JavierGranadoCIRCE/Alimak_RFID/mouser.png

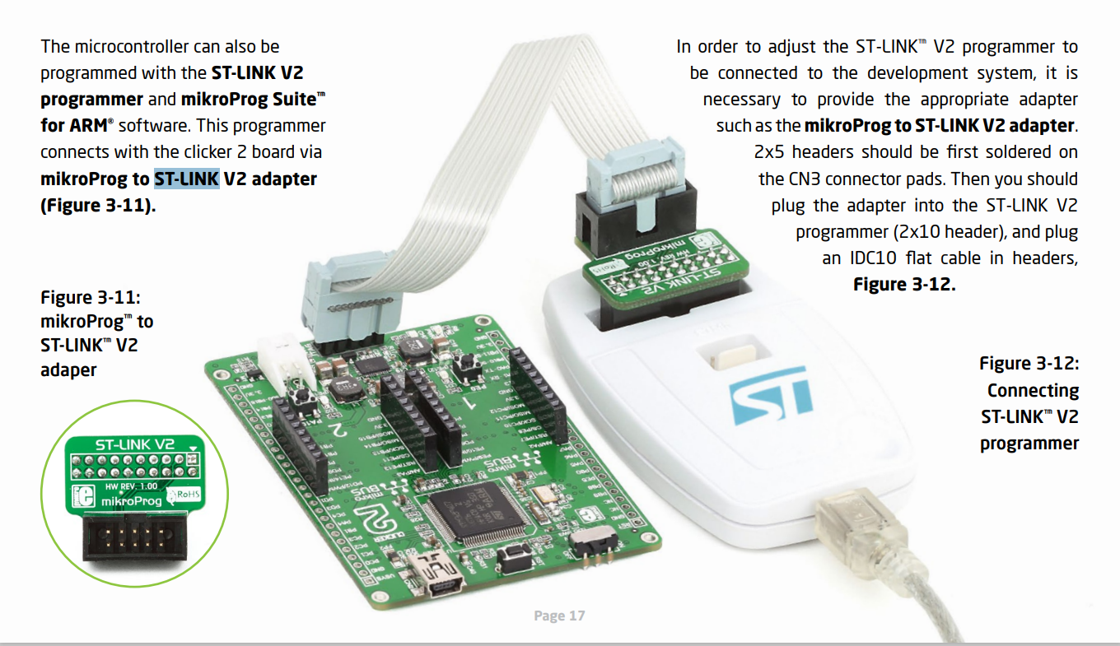
mouser.png
