JavierGranadoCIRCE/Alimak_RFID/Seguimiento_Doorlock_ALIMAK_19122025.odp

Actualización 19/12/2025

- Hemos puesto en marcha el setup del RFID
- Hemos verificado que a una distancia de unos 3 cm se detectan los Tags
- Hemos conseguido que funcione también quitando la antena de la pcb y sustituyéndola por una antena smd y modificando los condensadores del circuito resonante de la antena
- Vamoa a ir implementando el firmware para comunicarnos con el lector RFID desde el uControlador ST32

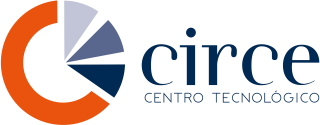
[picture p30: figure]
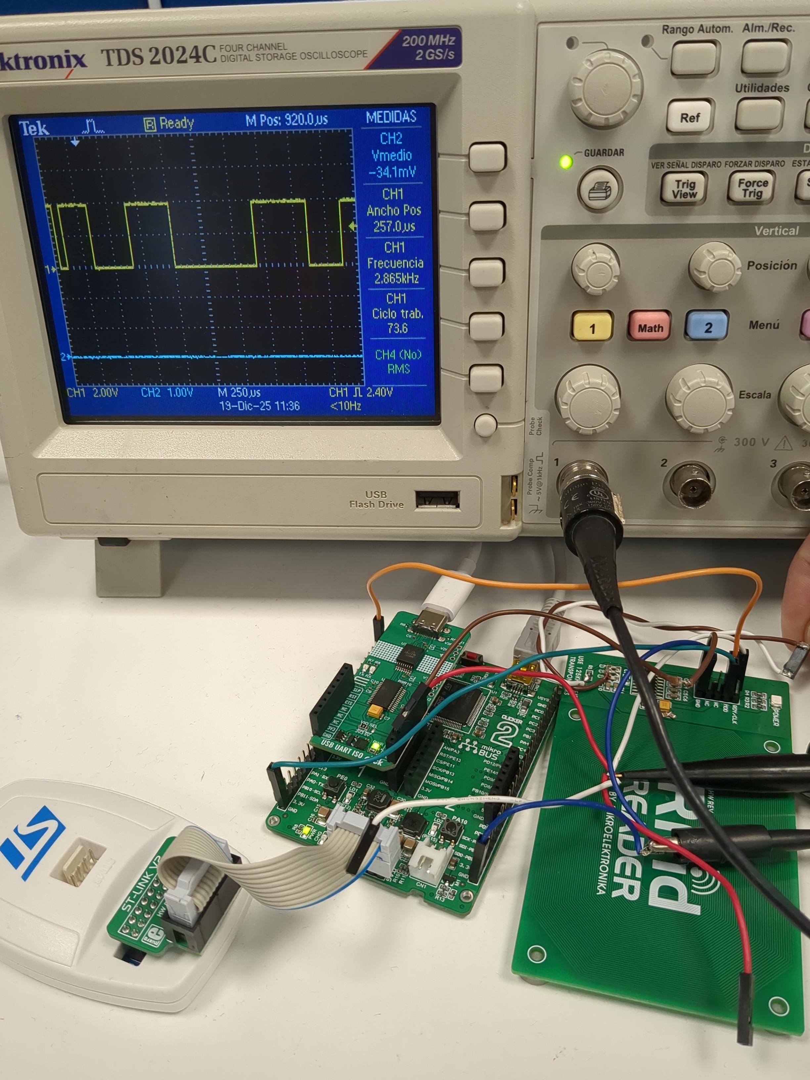
[picture p31: figure]
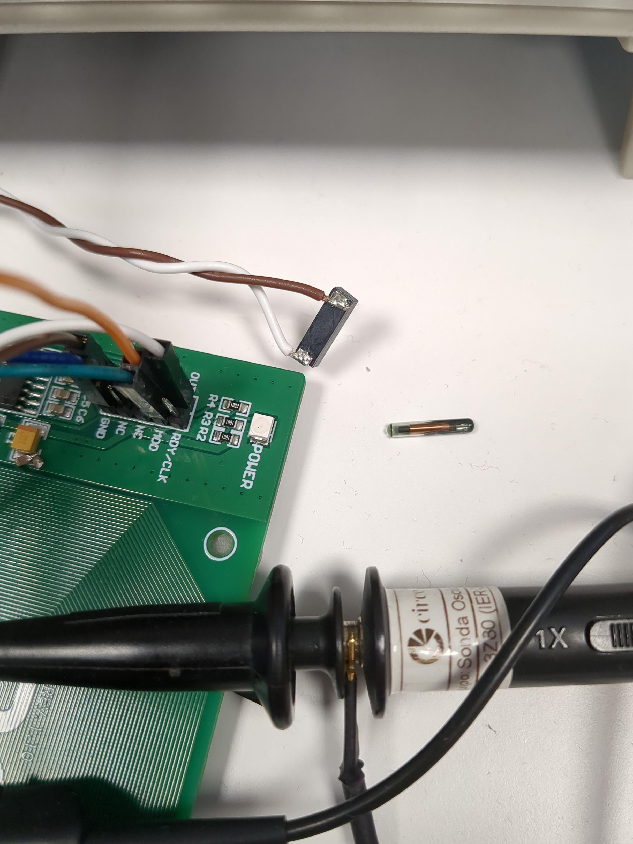
[picture p32: figure]

Notes: 101
