JavierGranadoCIRCE/Alimak_RFID/Seguimiento_Doorlock_ALIMAK_31102025.odp

## Slide 3

Estudio sensores Hall (puerta bloqueada)

Notes: 84

## Slide 4

Estudio sensores Hall (puerta bloqueada)

Problema del diseño actual:

Con dos sensores Hall digitales (todo/nada) que leen un mismo imán, hay redundancia, pero:

  - No hay forma de detectar fallos correlados (CCF) como que ambos se saturen o cortocircuiten a “1” o a “0”.
  - El DCavg (cobertura diagnóstica) es prácticamente nulo si solo se lee sus estados lógicos.
  - Si ambos sensores quedan atascados en nivel alto, el sistema podría pensar que el bloqueo está hecho cuando no lo está → fallo peligroso no detectado.

Eso impide justificar PLd…

Notes: CCF: Common Cause Failure, o fallo por causa común. Se refiere a la probabilidad de que ambos canales redundantes fallen a la vez por la misma causa (por ejemplo, una sobretensión, una temperatura extrema, un error de diseño, interferencias electromagnéticas, etc.). En una arquitectura redundante de seguridad (como dos relés K1 y K2): - Se asume que cada canal puede fallar independientemente. - Pero si una causa externa provoca que ambos fallen al mismo tiempo, la redundancia ya no protege nada.
- Por eso hay que demostrar que la probabilidad de fallo común está suficientemente reducida.
CCF ≥ 65: En la ISO 13849-1, el Anexo F establece un sistema de puntuación: - Cada medida de protección contra fallos comunes suma puntos. - Se exige alcanzar al menos 65 puntos para cumplir los requisitos de CCF en categorías 2, 3 y 4. Por eso se dice: “CCF ≥ 65” → los canales están suficientemente protegidos frente a fallos por causa común.
Cómo se consiguen esos puntos (según el Anexo F de la ISO 13849-1) -Separación física de canales 15 K1 y K2 en zonas distintas de la PCB y/o con pistas separadas. -Diversidad tecnológica o de diseño 20 Usar relés de distinto fabricante o controladores distintos. -Protección frente a sobretensiones, ruido EMI 10 TVS, filtros EMC, ferritas, optoaislamiento. -Fuentes de alimentación independientes 10 Cada canal con fusible o regulador separado. -Pruebas periódicas automáticas 15 Test de soldadura y discrepancia en cada ciclo. -Protección frente a sobretemperatura o vibración 5 Componentes certificados o pruebas de entorno. Si la suma de las medidas implementadas ≥ 65 → se considera que la probabilidad de fallo común es suficientemente baja.
CCF ≥ 65: separación física de canales, protección frente a sobretensiones, fuentes separadas o protecciones dedicadas, etc. (lista del Anexo F) Significa que: -Para alcanzar PL d, Cat. 3, nuestro diseño debe demostrar que los dos canales (K1 y K2) no pueden fallar simultáneamente por la misma causa. - Esto se logra aplicando las medidas anteriores (separación física, alimentación independiente, protección EMC, etc.) hasta acumular al menos 65 puntos en la tabla del Anexo F de la norma.
85

## Slide 5

Estudio sensores Hall (puerta bloqueada)

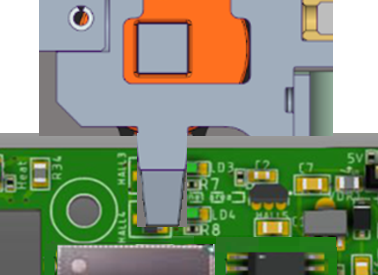
[picture p46: figure]

Sensores Hall digitales

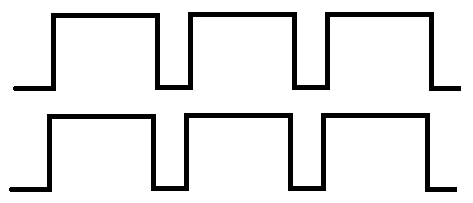
[picture p47: figure]

Hall1

Hall2

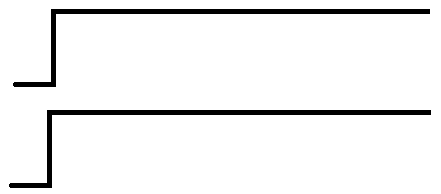
[picture p48: figure]

Cortocircuito a VCC en los dos sensores!!!

Fallo no detectado!!

Notes: 86

## Slide 6

Estudio sensores Hall (puerta bloqueada)

  - Propuesta: 2 sensores Hall analógicos redundantes
  - Características:
  - Diagnóstico de coherencia y plausibilidad
  - Hay que comparar Hall1 y Hall2 continuamente.
  - Si las dos lecturas difieren más allá de una ventana (ej. ±10 %), o si una se sale de rango (0 V, saturación, ruido), se genera fallo seguro.
  - Esto permite justificar DCavg medio/alto (~90 %) según el Anexo E de la norma (ISO 13849-1:2024)
  - Detección de fallos típicos:
  - Corto a GND o VCC → fuera de ventana.
  - Desmagnetización parcial → valor fuera de umbral.
  - Deriva térmica → incoherencia temporal.
  - Ruido o vibración → inestabilidad detectada por supervisión temporal.
  - Mitigación del fallo común (CCF):
  - Si se ubican físicamente separados (unos mm de diferencia en la trayectoria del imán).
  - Si se cablean en rutas independientes.
  - Si se alimentan por ramas separadas del MCU (ADC1/ADC2 con fuentes distintas).
  - Se puede justificar ≥ 65 pt en el Anexo F (CCF), lo que es requisito para PL d (ISO 13849-1:2024)
  - Ventana de validación física:
  - Al usar sensores analógicos, se puede definir una ventana de campo magnético válida (p. ej. entre 1.2 V y 2.8 V = pin bloqueado).
  - Si el imán está muy lejos o demasiado cerca, se considera no bloqueado o fallo.

Notes: MTTFd alto (30–100 años): “Mean Time To Dangerous Failure”, es decir, Tiempo medio hasta un fallo peligroso. Los sensores Hall no tienen partes móviles, por lo que su tasa de fallo aleatorio (λd) es muy baja. Según las tablas de la ISO 13849-1:2024, Anexo C, los dispositivos electrónicos simples con semiconductores estables pueden asignarse a la categoría MTTFd “High” (>30 años). Esto significa que la probabilidad de un fallo peligroso aleatorio es muy baja, y contribuye positivamente al cálculo global del Performance Level (PL). En la práctica, los valores típicos proporcionados por fabricantes (Honeywell, Allegro, Vishay) están en el rango 100–300 FITs, que equivalen a MTTFd de 50–100 años bajo condiciones nominales.
Dcavg: DCavg = Average Diagnostic Coverage → Cobertura diagnóstica media Mide qué porcentaje de fallos peligrosos de un subsistema pueden ser detectados por los mecanismos de diagnóstico antes de que generen una situación de riesgo. DCavg ≈ 90 % (Coherencia + Rango + Test temporal) El Diagnostic Coverage (DCavg) mide qué porcentaje de fallos peligrosos son detectados antes de causar una situación de riesgo. En este diseño se alcanzan valores altos gracias a tres mecanismos complementarios: Coherencia → comparación continua de las dos señales analógicas Hall (Hall1 vs Hall2): si difieren más allá de una tolerancia → fallo. Rango → verificación de que cada sensor se mantiene dentro de una ventana válida de tensión (p. ej. 1.2 – 2.8 V): saturaciones, cortos, rupturas o magnetismo insuficiente → fallo. Test temporal → supervisión cíclica (cada ciclo de CPU) que asegura detección de fallos latentes antes de la siguiente demanda de la función. Según el Anexo E de la ISO 13849-1, la combinación de coherencia + plausibilidad + supervisión temporal permite clasificar el DCavg como “High” (~90 %).
CCF ≥ 65 pt (Diversidad + Separación + EMC) El Common Cause Failure (CCF) evalúa la probabilidad de que ambos canales redundantes fallen simultáneamente por una misma causa. La norma exige ≥ 65 puntos para alcanzar Categoría 3 / PL d. En este caso, se logra gracias a: Diversidad física: Posiciones mecánicas distintas, aunque muy cercanas, lo que da una ligera diversidad en la medida que robustece más la medida. Separación eléctrica: alimentación desde reguladores o líneas independientes, y uso de ADC distintos dentro de la MCU. Protección EMC: filtrado, apantallamiento y separación de cableado de señal frente a potencia, cumpliendo los criterios del Anexo F. Esta combinación permite justificar ≥ 65 pt en la tabla de valoración del Anexo F. 87

## Slide 7

Estudio sensores Hall (puerta bloqueada)

  - Implementación práctica (prototipo)
- Colocar los sensores en posiciones ligeramente distintas (uno detecta el imán en la situación de bloqueo y el otro en la de desbloqueo).
- Alimentarlos desde dos reguladores separados o líneas aisladas del MCU (para CCF).
- Conectarlos a ADC independientes y ejecutar diagnóstico cíclico
- En firmware: modo seguro ante fallo → desactivar salidas (OSSD o Relés).

Justificación normativa

- MTTFd alto: sensores electrónicos sin partes móviles (30–100 años).
- DCavg ≈ 90 % (coherencia + rango + test temporal).
- CCF ≥ 65 pt (diversidad + separación + EMC).

Cumple Categoría 3 / PL d para la subfunción de bloqueo.

Notes: MTTFd alto (30–100 años): “Mean Time To Dangerous Failure”, es decir, Tiempo medio hasta un fallo peligroso. Los sensores Hall no tienen partes móviles, por lo que su tasa de fallo aleatorio (λd) es muy baja. Según las tablas de la ISO 13849-1:2024, Anexo C, los dispositivos electrónicos simples con semiconductores estables pueden asignarse a la categoría MTTFd “High” (>30 años). Esto significa que la probabilidad de un fallo peligroso aleatorio es muy baja, y contribuye positivamente al cálculo global del Performance Level (PL). En la práctica, los valores típicos proporcionados por fabricantes (Honeywell, Allegro, Vishay) están en el rango 100–300 FITs, que equivalen a MTTFd de 50–100 años bajo condiciones nominales.
Dcavg: DCavg = Average Diagnostic Coverage → Cobertura diagnóstica media Mide qué porcentaje de fallos peligrosos de un subsistema pueden ser detectados por los mecanismos de diagnóstico antes de que generen una situación de riesgo. DCavg ≈ 90 % (Coherencia + Rango + Test temporal) El Diagnostic Coverage (DCavg) mide qué porcentaje de fallos peligrosos son detectados antes de causar una situación de riesgo. En este diseño se alcanzan valores altos gracias a tres mecanismos complementarios: Coherencia → comparación continua de las dos señales analógicas Hall (Hall1 vs Hall2): si difieren más allá de una tolerancia → fallo. Rango → verificación de que cada sensor se mantiene dentro de una ventana válida de tensión (p. ej. 1.2 – 2.8 V): saturaciones, cortos, rupturas o magnetismo insuficiente → fallo. Test temporal → supervisión cíclica (cada ciclo de CPU) que asegura detección de fallos latentes antes de la siguiente demanda de la función. Según el Anexo E de la ISO 13849-1, la combinación de coherencia + plausibilidad + supervisión temporal permite clasificar el DCavg como “High” (~90 %).
CCF ≥ 65 pt (Diversidad + Separación + EMC) El Common Cause Failure (CCF) evalúa la probabilidad de que ambos canales redundantes fallen simultáneamente por una misma causa. La norma exige ≥ 65 puntos para alcanzar Categoría 3 / PL d. En este caso, se logra gracias a: Diversidad física: Posiciones mecánicas distintas, aunque muy cercanas, lo que da una ligera diversidad en la medida que robustece más la medida. Separación eléctrica: alimentación desde reguladores o líneas independientes, y uso de ADC distintos dentro de la MCU. Protección EMC: filtrado, apantallamiento y separación de cableado de señal frente a potencia, cumpliendo los criterios del Anexo F. Esta combinación permite justificar ≥ 65 pt en la tabla de valoración del Anexo F. 88

## Slide 8

Estudio sensores Hall (puerta bloqueada)

  - Implementación práctica (prototipo)
- Colocar los sensores en posiciones ligeramente distintas (al irse moviendo el actuador, los niveles analógicos de las salidas de cada sensor van evolucionando de distinta manera)
- Alimentarlos desde dos reguladores separados o líneas aisladas del MCU (para CCF).
- Conectarlos a ADC’s independientes y ejecutar diagnóstico cíclico
- En firmware: modo seguro. Ante fallo → desactivar OSSD/Relés.

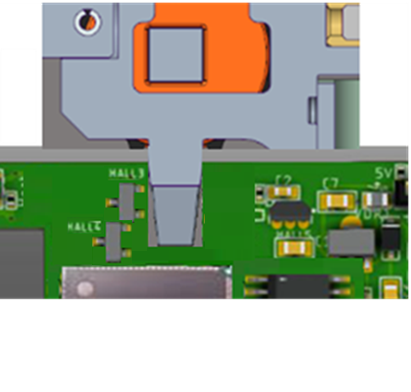
[picture p49: figure]
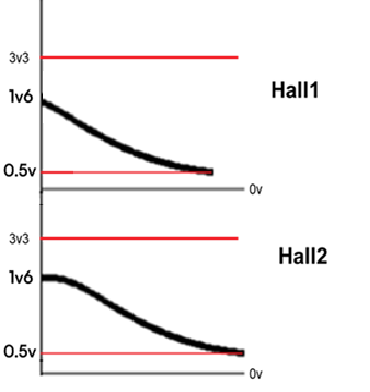
[picture p50: figure]

Notes: 89

## Slide 9

Estudio sensores Hall (puerta bloqueada)

  - Criterios de selección

Para asegurar redundancia, diagnóstico, buen rango industrial y compatibilidad con el MCU, se proponen los siguientes criterios:

1. Salida analógica ratiométrica (no solo “pasa/no pasa”) → permite ventana de valores, coherencia entre sensores, diagnóstico de fallo.
1. Rango de tensión compatible con la alimentación que usada (por ejemplo 3.3 V o 5 V) y entrada ADC del MCU. El STM32H7 dispone de ADCs de alta precisión, que permiten muestrear los sensores.
1. Buena estabilidad térmica y ruido bajo, para que la comparación entre sensores (Hall1 vs Hall2) sea fiable y el diagnóstico de fallo sea robusto.
1. Encapsulado industrial (temperatura, vibración, montaje mecánico) porque se trata de un elevador y un mecanismo de bloqueo — ambiente exigente.
1. Buen diagnóstico / fallo abierto o cerrado: es decir, que se pueda detectar sensor fuera de rango, falta de magnetismo, saturación, cableado abierto, etc.

Notes: Concepto básico Un sensor ratiométrico es aquel cuya salida analógica varía de forma proporcional (“ratio”) a su tensión de alimentación. En fórmula sencilla: donde: → tensión de salida del sensor, → sensibilidad (en mV/mT), → campo magnético detectado, → tensión de alimentación del sensor.
Ejemplo Si se alimenta el sensor con 5 V, el punto medio (sin campo) suele ser 2,5 V.
Si se alimenta con 3,3 V, ese punto medio será 1,65 V. Así, toda la curva de salida escala con la alimentación.
Por ejemplo: Campo magnético (mT) Salida a 5 V Salida a 3.3 V 0 mT (sin imán) 2.5 V 1.65 V +B (campo norte) 3.5 V 2.3 V –B (campo sur 1.5 V 1.0 V
Esto es importante porque si la tensión de alimentación varía, la salida también lo hace proporcionalmente → el microcontrolador puede compensarlo fácilmente al usar la misma referencia del ADC. Permite mayor precisión porque los errores por fluctuaciones de alimentación se cancelan. Además, se puede definir ventanas de validación relativas (porcentaje de Vcc), lo que simplifica el diagnóstico.
En nuestro caso usando el STM32H757, el ADC del STM32 usa la misma Vref (3.3 V o 5 V) que alimenta el sensor Hall.
Si ambos varían igual, la lectura digital del ADC no se ve afectada por variaciones de tensión de alimentación, lo que es ideal para una aplicación de seguridad como la nuestra 90

## Slide 10

Estudio sensores Hall (puerta bloqueada)

  - Propuesta de sensores
- Analog Devices AD22151: Sensor de precisión, buena linealidad; quizá algo más caro, pero útil para la redundancia de diagnosis.
- Allegro A1326/LUA‑T: Variante más coste-eficiente, analógica, podría usarse como segunda unidad para redundancia.

Notes: 91

## Slide 11

Estudio sensores Hall (puerta bloqueada)

  - Integración con el STM32H757
- El MCU STM32H757 ofrece varios ADCs de alta precisión que permiten muestreo rápido y uso de “analog watchdog” interno (ventana de supervisión)
- Alimentamos los sensores con una fuente estable (por ejemplo 3.3 V) si la referencia del ADC es esa.
- A nivel mecánico, hay que asegurarse de que los dos sensores estén instalados en sitios separados físicamente (por ejemplo, uno en el extremo de la posición de bloqueo y otro en el extremo de la posición de desbloqueo), con cableado separado, para mitigar fallo común (CCF) por vibración o fallo electromagnético.
- Definir ventanas/escalas de magnetismo: por ejemplo, cuando el imán está en posición de bloqueo se espera un valor de salida de ~1.6 V ± 0.3 V. En posición desbloqueado <0.8 V o >2.4 V. Ajustar el valor final con pruebas.

Notes: Lectura y supervisión con los ADC del STM32H757 El STM32H757 dispone de varios conversores analógico-digitales (ADC) de alta velocidad y resolución, lo que nos permite muestrear las salidas de los sensores Hall con gran precisión. Además, incorpora una función interna llamada “Analog Watchdog”, que actúa como una ventana de supervisión automática: si la señal del sensor sale de los límites configurados (por ejemplo, fuera de 0.8 V–2.4 V), el propio hardware genera una alerta inmediata. Esto nos permite implementar el diagnóstico de rango y coherencia directamente dentro del micro, sin añadir hardware adicional.
Alimentación estable y referencia común Los sensores Hall se alimentan desde una fuente estable y limpia (por ejemplo 3.3 V), que coincide con la referencia del ADC. Esto es importante porque los sensores son ratiométricos: su salida varía proporcionalmente con la tensión de alimentación. Al compartir la misma referencia que el ADC, cualquier pequeña variación de tensión se compensa automáticamente, garantizando lecturas estables y precisas incluso ante fluctuaciones de alimentación o temperatura.
Diseño mecánico y mitigación de fallos comunes (CCF) A nivel físico, colocamos los dos sensores en posiciones separadas pero muy cercanas, esto introduce diversidad física y reduce el riesgo de un fallo común, por ejemplo por vibraciones, interferencias electromagnéticas o alineación imprecisa del imán. Además, cada sensor tiene su propio cableado hacia la MCU, de modo que una rotura o interferencia en un cable no afecte al otro canal. En conjunto, esto refuerza la independencia funcional de los canales, lo que es un requisito para alcanzar Categoría 3 / PL d.
Definición de ventanas y calibración del magnetismo En la práctica, definimos ventanas de tensión que representan estados válidos: Por ejemplo, en posición bloqueada, el sensor entrega unos 1.6 V ± 0.3 V. En posición desbloqueada, el valor cae fuera de esa ventana (< 0.8 V o > 2.4 V). Estos valores se ajustan experimentalmente durante el prototipo, calibrando con el imán real y el montaje mecánico final. La MCU supervisa constantemente esas tensiones y, ante cualquier desviación, entra en modo seguro, desactivando las salidas OSSD o relés.
En resumen, esta integración entre los sensores Hall y el STM32H757 permite tener una detección analógica redundante, autodiagnosticada y robusta frente a fallos comunes, cumpliendo las exigencias de la ISO 13849 para la función puerta bloqueada. 92

## Slide 12

Elección del µControlador

Notes: 93

## Slide 13

Elección del µControlador

Función dentro del sistema de seguridad:

El microcontrolador actúa como el núcleo lógico de la función de seguridad, encargado de:

- Evaluar las entradas seguras (RFID y sensores Hall redundantes).
- Determinar el estado de seguridad (cerrado y bloqueado).
- Gestionar las salidas OSSD/Relés dobles hacia el sistema de control del elevador.
- Ejecutar diagnósticos continuos de coherencia, temporización y fallos cruzados.

El microcontrolador forma parte esencial del subsistema de control de seguridad (SRP/CS) definido por la ISO 13849-1.

Notes: 94

## Slide 14

Elección del µControlador

Características de seguridad funcional relevantes:

- Arquitectura interna redundante: El STM32H757 integra dos cores ARM Cortex-M (M7 + M4) que pueden ejecutarse en modo redundante, para poder realizar verificación cruzada de tareas críticas.

- Autodiagnóstico mediante el STM32 Safety Pack, el sistema incorpora:

    - - Self-Test Library (STL): pruebas periódicas de CPU, RAM (March C-), Flash, reloj y FPU.

- Watchdogs independientes para detección de bloqueos de software y de hardware.

- Supervisión de integridad de las salidas (comparación continua de OSSD o Relés).

- Pruebas de arranque (power-on self-test) para detectar fallos latentes antes de la habilitación de las salidas seguras.

- Diagnóstico y cobertura (DC): El Safety Pack proporciona bloques de diagnóstico que facilitan justificar DC medio/alto (≈ 90 %) en el conjunto de la función, contribuyendo a alcanzar PL d.

- ST ofrece además FMEDA y Safety Manual certificados TÜV SÜD hasta SIL 2 / PL d, que detallan los modos de fallo y las medidas de mitigación requeridas.

- Control de salidas OSSD/Relés: La MCU controla las señales OSSD a través del driver VNQ5050AK-E, o de Relés:

STM8 & STM32 Functional Safety - STMicroelectronics (https://www.st.com/content/st_com/en/ecosystems/functionalsafety.html?utm_source=chatgpt.com)

Notes: FMEDA (Failure Modes, Effects and Diagnostic Analysis) Es un documento técnico que ST proporciona para cada microcontrolador “safety qualified”. Contiene: -Una tabla completa de modos de fallo de los bloques internos del MCU (CPU, RAM, Flash, periféricos, watchdogs, GPIO, etc.). -El porcentaje de fallos peligrosos detectables mediante autodiagnósticos (lo que permite estimar el Diagnostic Coverage o DC). -Cálculos de MTTFd (tiempo medio hasta fallo peligroso) de los componentes internos. -Cómo deben supervisarse o duplicarse ciertos recursos para alcanzar un nivel de integridad determinado (SIL 2 / PL d). En otras palabras, el FMEDA da la “radiografía” de fiabilidad interna del microcontrolador y permite incluir esos valores en el FMEDA del sistema global (la función de puerta cerrada y bloqueada, en nuestro caso).
Safety Manual Es un manual oficial de seguridad funcional del componente, redactado y validado por TÜV SÜD (organismo certificador independiente). En él se explica: -Cómo usar el microcontrolador de forma segura. -Qué bloques de hardware son aptos para seguridad (por ejemplo, qué GPIOs tienen test, qué watchdogs son recomendados). -Qué autotests y configuraciones son obligatorios (por ejemplo, verificar Flash en arranque, usar doble watchdog, etc.). -Qué requisitos de desarrollo y prueba debe cumplir el firmware para mantener ese nivel. Este documento es como la guía oficial para integrar el STM32H757 en una arquitectura con seguridad funcional conforme a ISO 13849-1 o IEC 61508.
Certificación TÜV SÜD hasta SIL 2 / PL d Significa que un organismo acreditado (TÜV SÜD) ha auditado los procesos y resultados de ST y ha emitido un certificado de conformidad indicando que: La MCU y su ecosistema Safety Pack pueden utilizarse en sistemas hasta SIL 2 (IEC 61508) o PL d (ISO 13849-1). Los FMEDA y Safety Manual cumplen los requisitos metodológicos de ambas normas. Esto no certifica el producto final de forma automática, pero reduce drásticamente el esfuerzo que vamos a necesitar hacer para la validación:
Así solo tendremos que demostrar que integramos el MCU siguiendo las recomendaciones del Safety Manual y que nuestro software cumple el DC y CCF requeridos.
En nuestro proyecto DoorLock, respecto al expediente técnico, esta información nos sirve para escribir algo como: “El microcontrolador STM32H757 dispone de documentación de seguridad funcional (Safety Manual y FMEDA certificados por TÜV SÜD hasta SIL 2 / PL d), lo que permite su integración en arquitecturas Cat. 3 con diagnóstico medio/alto, garantizando el cumplimiento de los requisitos de ISO 13849-1 para la función ‘puerta cerrada y bloqueada’.” 95

## Slide 15

Elección del µControlador

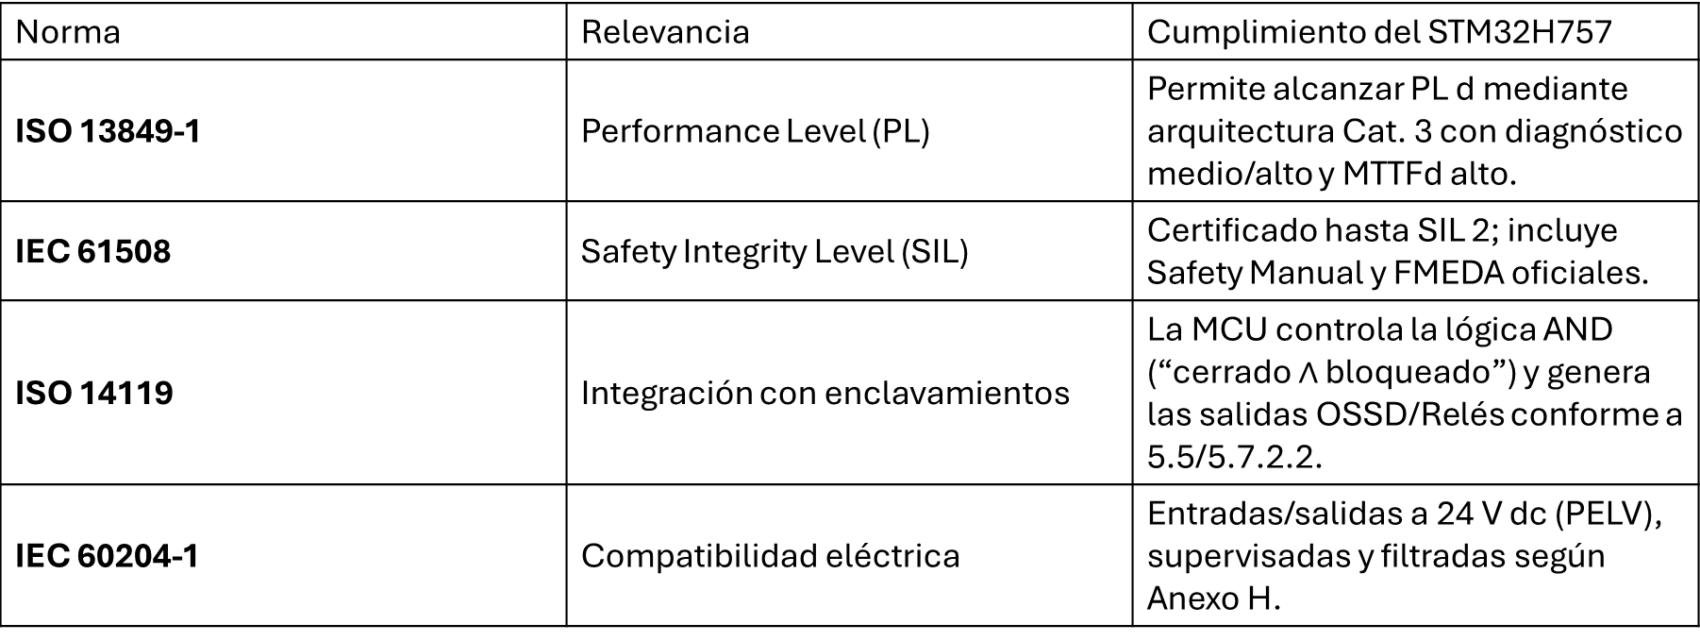
[picture p51: figure]

Norma | Relevancia | Cumplimiento del STM32H757
ISO 13849-1 | Performance Level (PL) | Permite alcanzar PL d mediante arquitectura Cat. 3 con diagnóstico medio/alto y MTTFd alto.
IEC 61508 | Safety Integrity Level (SIL) | Certificado hasta SIL 2; incluye Safety Manual y FMEDA oficiales.
ISO 14119 | Integración con enclavamientos | La MCU controla la lógica AND (“cerrado ∧ bloqueado”) y genera las salidas OSSD/Relés conforme a 5.5/5.7.2.2.
IEC 60204-1 | Compatibilidad eléctrica | Entradas/salidas a 24 V dc (PELV), supervisadas y filtradas según Anexo H.

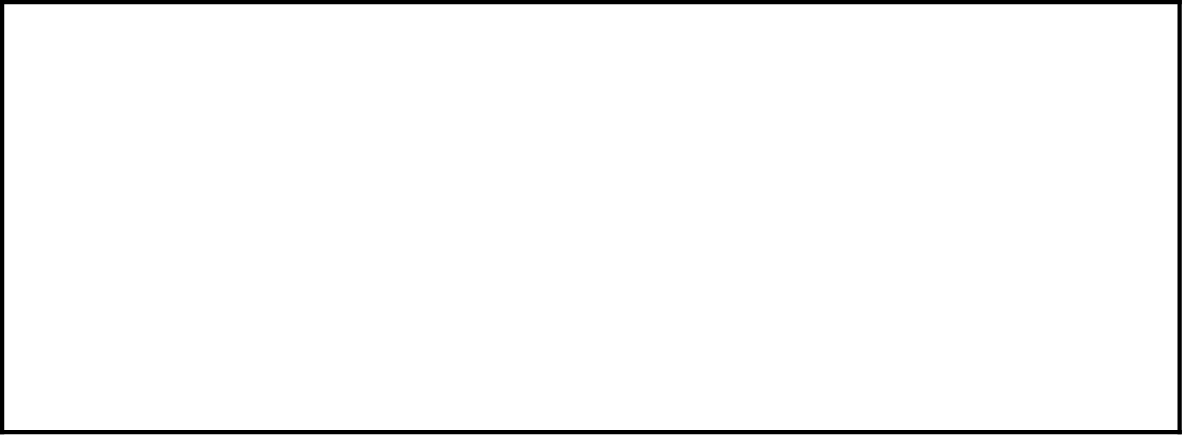
[picture p52: figure]

Notes: ISO 13849-1 – Performance Level (PL) Esta es la norma clave para seguridad funcional en maquinaria, y es la que aplica directamente a la función “puerta bloqueada” del elevador. Lo que exige es demostrar que el sistema alcanza un nivel de prestaciones (PL) suficiente —en nuestro caso, PL d— mediante tres pilares:
MTTFd alto, diagnóstico eficaz (DCavg) y protección frente a fallos comunes (CCF). El STM32H757, combinado con el Safety Pack, permite implementar: Diagnósticos de coherencia y plausibilidad (lectura redundante de sensores Hall y supervisión de salidas OSSD). Supervisión temporal y watchdogs internos. Lógica redundante Cat. 3, de manera que un fallo simple no compromete la función. En resumen: esta MCU facilita alcanzar PL d sin añadir un segundo procesador.
IEC 61508 – Safety Integrity Level (SIL) ST ha certificado la familia STM32H7 hasta SIL 2, lo que equivale aproximadamente a PL d en ISO 13849. Lo importante aquí es que ST proporciona documentación oficial certificada por TÜV SÜD: Un Safety Manual, que describe cómo configurar el hardware y los tests de autodiagnóstico. Un FMEDA, que detalla los modos de fallo y los niveles de cobertura diagnóstica. Esto significa que no partimos de cero: el microcontrolador ya cumple una parte significativa de los requisitos de seguridad, lo que simplifica el expediente técnico del proyecto.
ISO 14119 – Integración con enclavamientos En este caso, la MCU controla la lógica de enclavamiento, aplicando la condición: Además, genera las salidas OSSD o relés de seguridad según los requisitos de los apartados 5.5 y 5.7.2.2 de la norma (coherencia, redundancia, supervisión y rearme controlado). En otras palabras, el STM32 no es solo el “cerebro” del sistema, sino también el supervisor de la lógica de seguridad funcional.
IEC 60204-1 – Compatibilidad eléctrica Afecta a cómo se conectan las entradas y salidas de la MCU: Deben funcionar con señales PELV (Protective Extra-Low Voltage), normalmente 24 V DC, con aislamiento adecuado. Las líneas deben estar filtradas y supervisadas según el Anexo H, para evitar activaciones espurias por ruido eléctrico.
Resumen: La elección del STM32H757 no se ha hecho solo por prestaciones técnicas, sino porque nos permite justificar con base normativa cada requisito de seguridad funcional:
cumple la ISO 13849 para el nivel PL d, la IEC 61508 para SIL 2, la ISO 14119 para la integración con enclavamientos, y la IEC 60204-1 para compatibilidad eléctrica.
96

## Slide 16
