JavierGranadoCIRCE/Alimak_RFID/Seguimiento_Doorlock_ALIMAK_04022026.odp

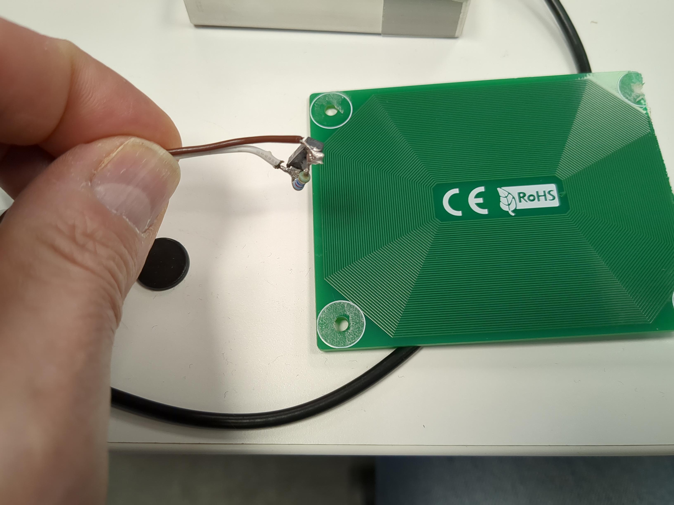
[picture p60: figure]
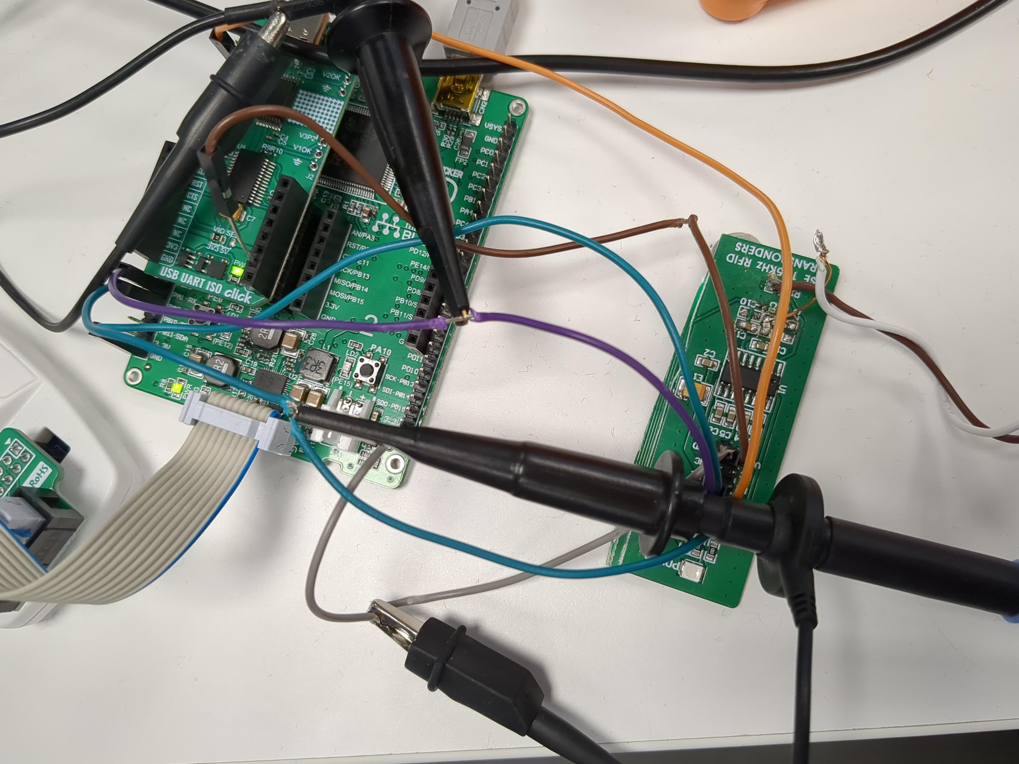
[picture p61: figure]

Actualización 04/02/2026


Antena smd

Antena pcb

Tag cristal

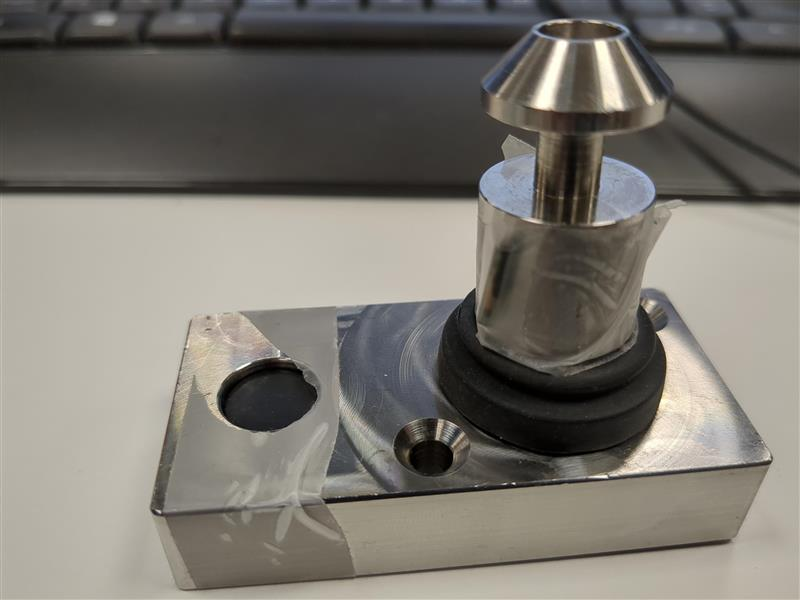
[picture p62: figure]

Tag redondo

Notes: 103

## Slide 2

Actualización 04/02/2026

Señal en la antena sin Tag presente

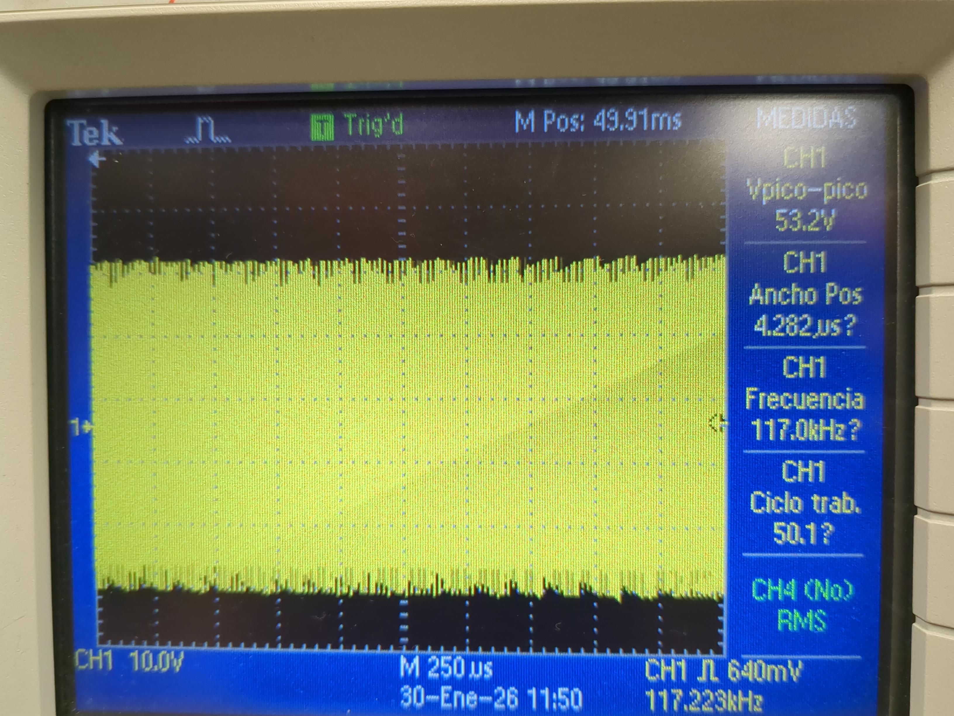
[picture p63: figure]
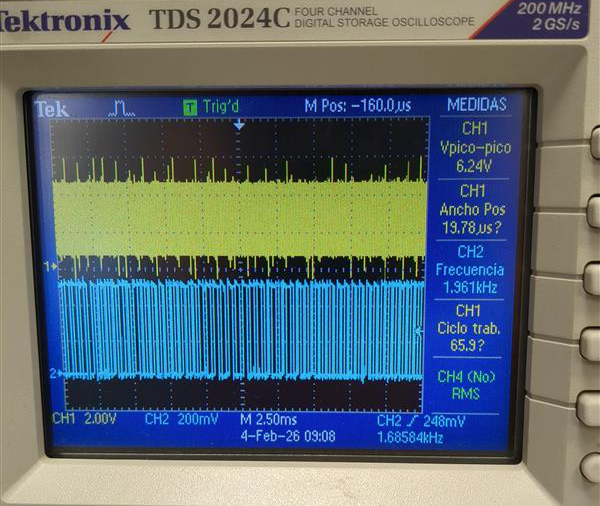
[picture p64: figure]

Señal de clock (125 khzz)

canal amarillo

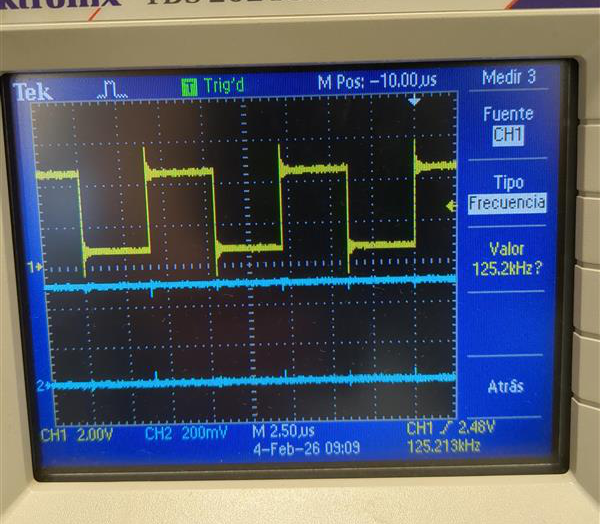
[picture p65: figure]
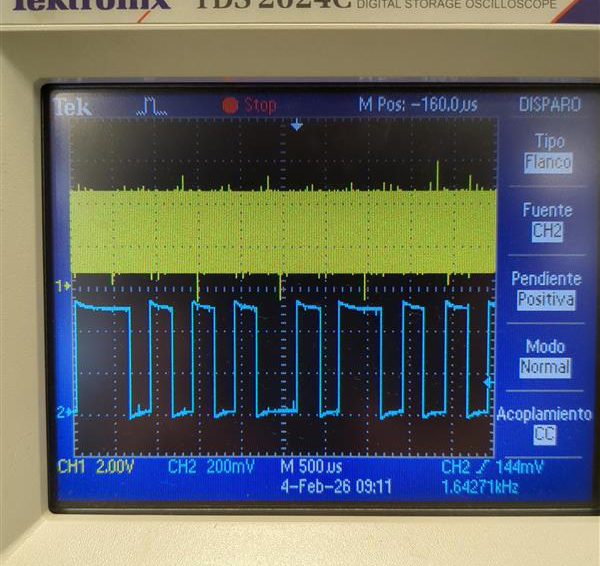
[picture p66: figure]

Señal OUT hacia el uC modulada por el Tag (2 khz)

Canal azúl

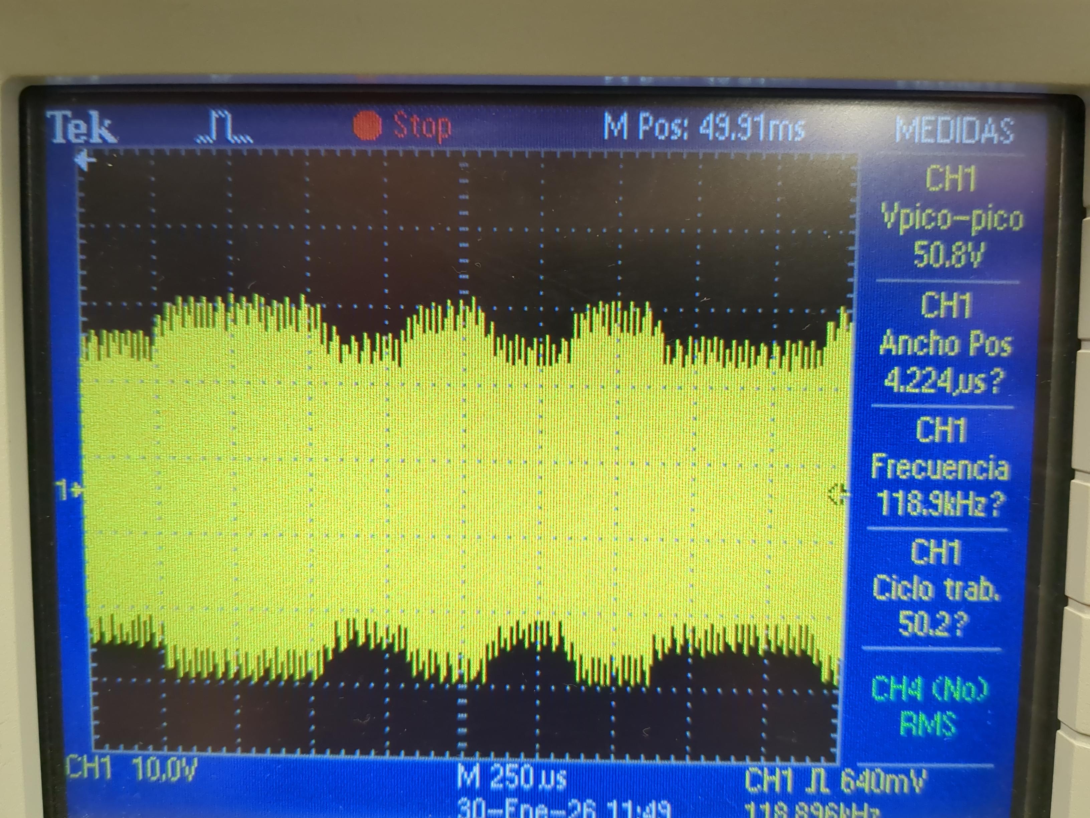
[picture p67: figure]

Señal en la antena modulada por el Tag

Notes: 103

## Slide 3

Actualización 04/02/2026

- Hemos conseguido sintonizar la antena smd/condensadores para sacar 125 khz
- Hemos conseguido ver la señal modulada en la antena por el Tag (disco y cristal en el pin)
- Hemos conseguido sintonizar la antena smd/condensadores para sacar 125 khz
- Hemos conseguido hacer un Firmware mínimo para leer el Tag filtrando el ruido y conseguir detectar

presencia/ausencia de Tag de forma robusta midiendo los tiempos de bit

- NO hemos conseguido aún demodular el manchester para sacar el ID

Pasos a seguir:

- Seguir modificando el Firmware
- Comprar antenas de bobina para ver si mejora la relación señal/ruido

Notes: 103
