JavierGranadoCIRCE/Alimak_RFID/Doc RFID/SDTR0602D-Series_.pdf

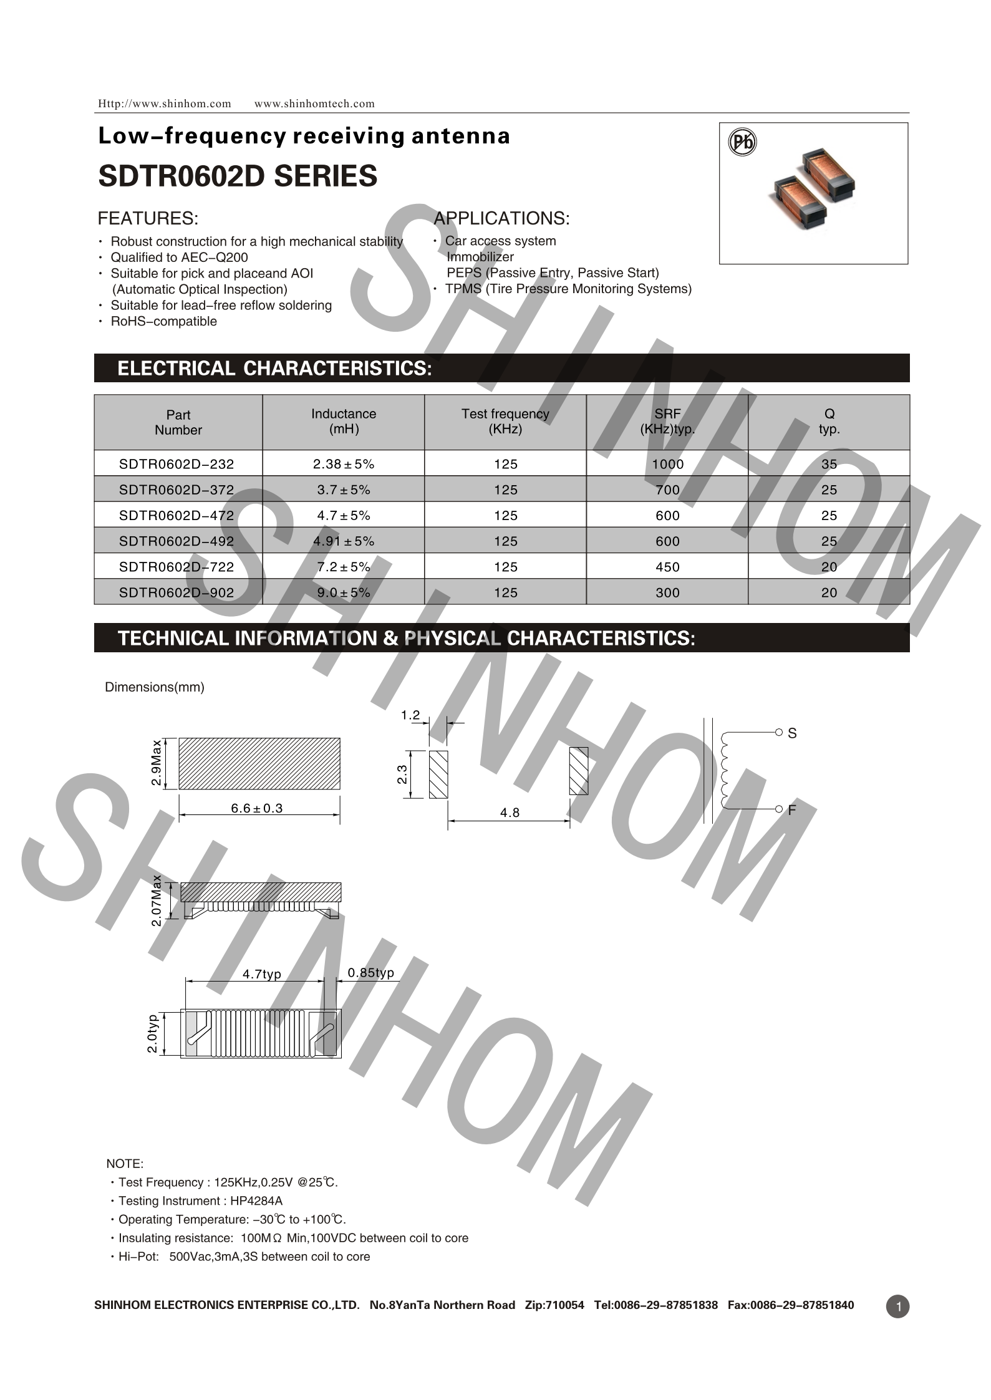
[picture p71: page 1]
