JavierGranadoCIRCE/Alimak_RFID/2502_Doorlock_schematic_ProtoA.pdf

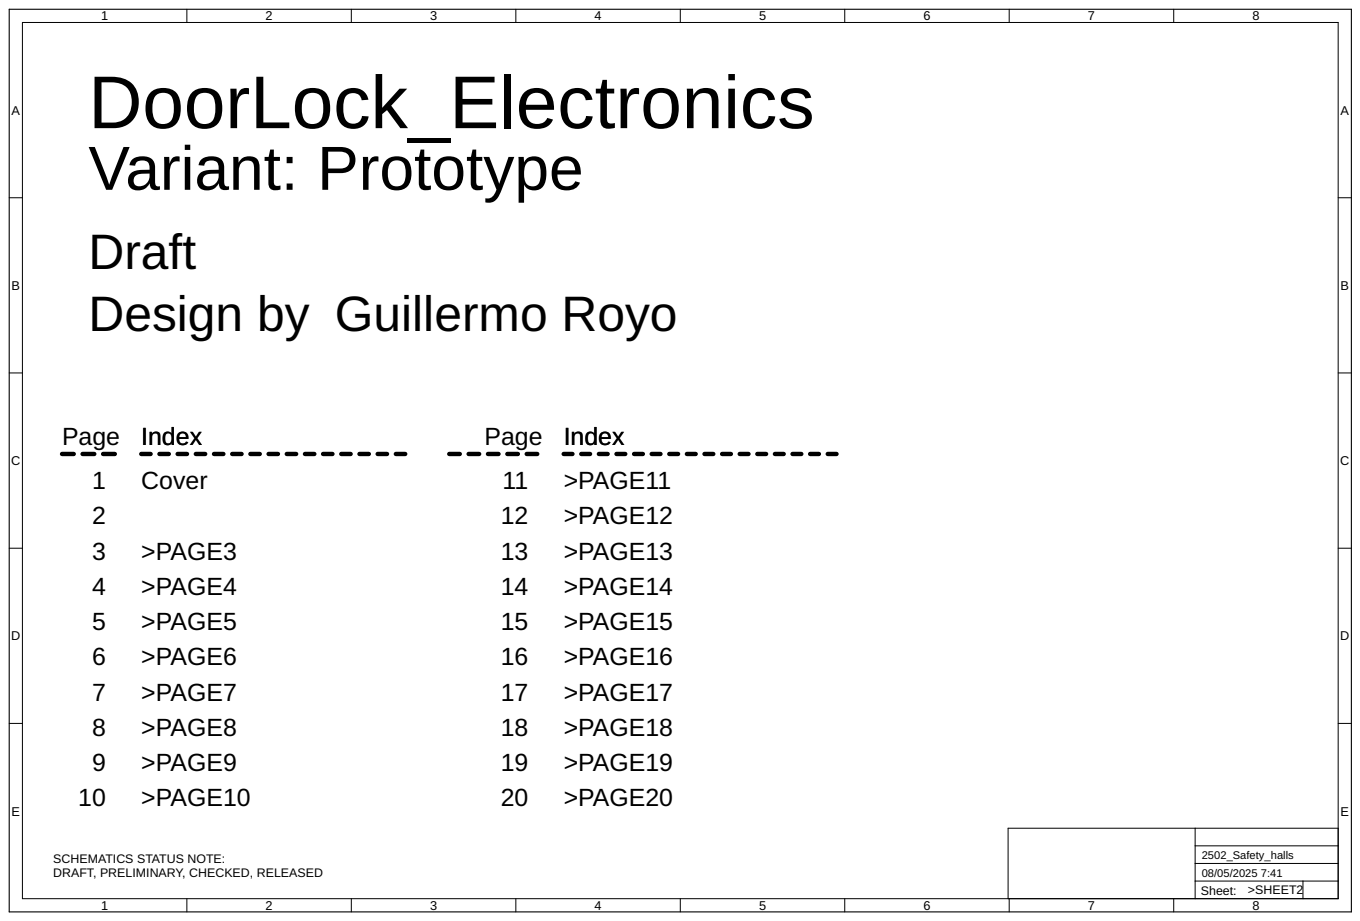
[picture p72: page 1]

SCHEMATICS STATUS NOTE:
DRAFT, PRELIMINARY, CHECKED, RELEASED

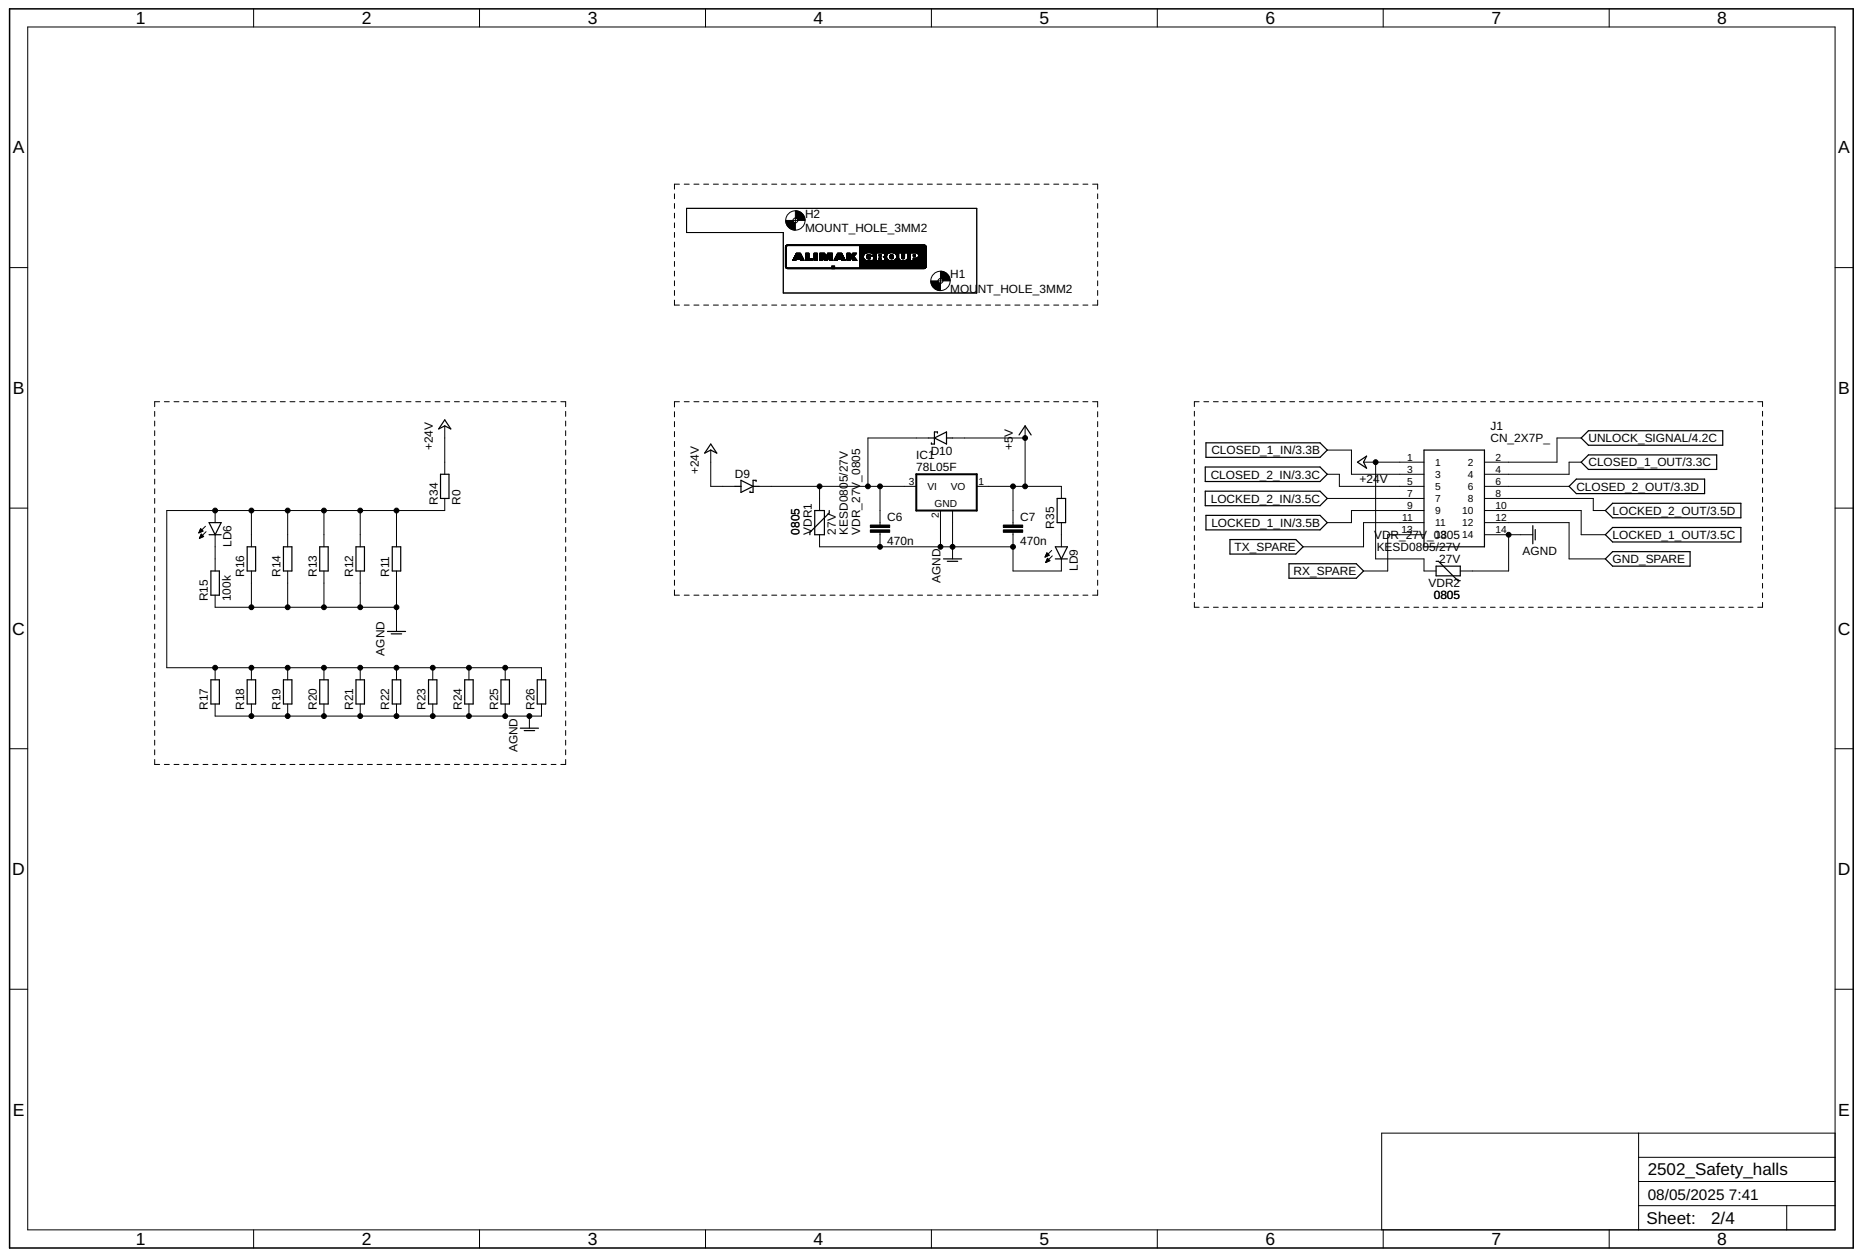
[picture p73: page 2]

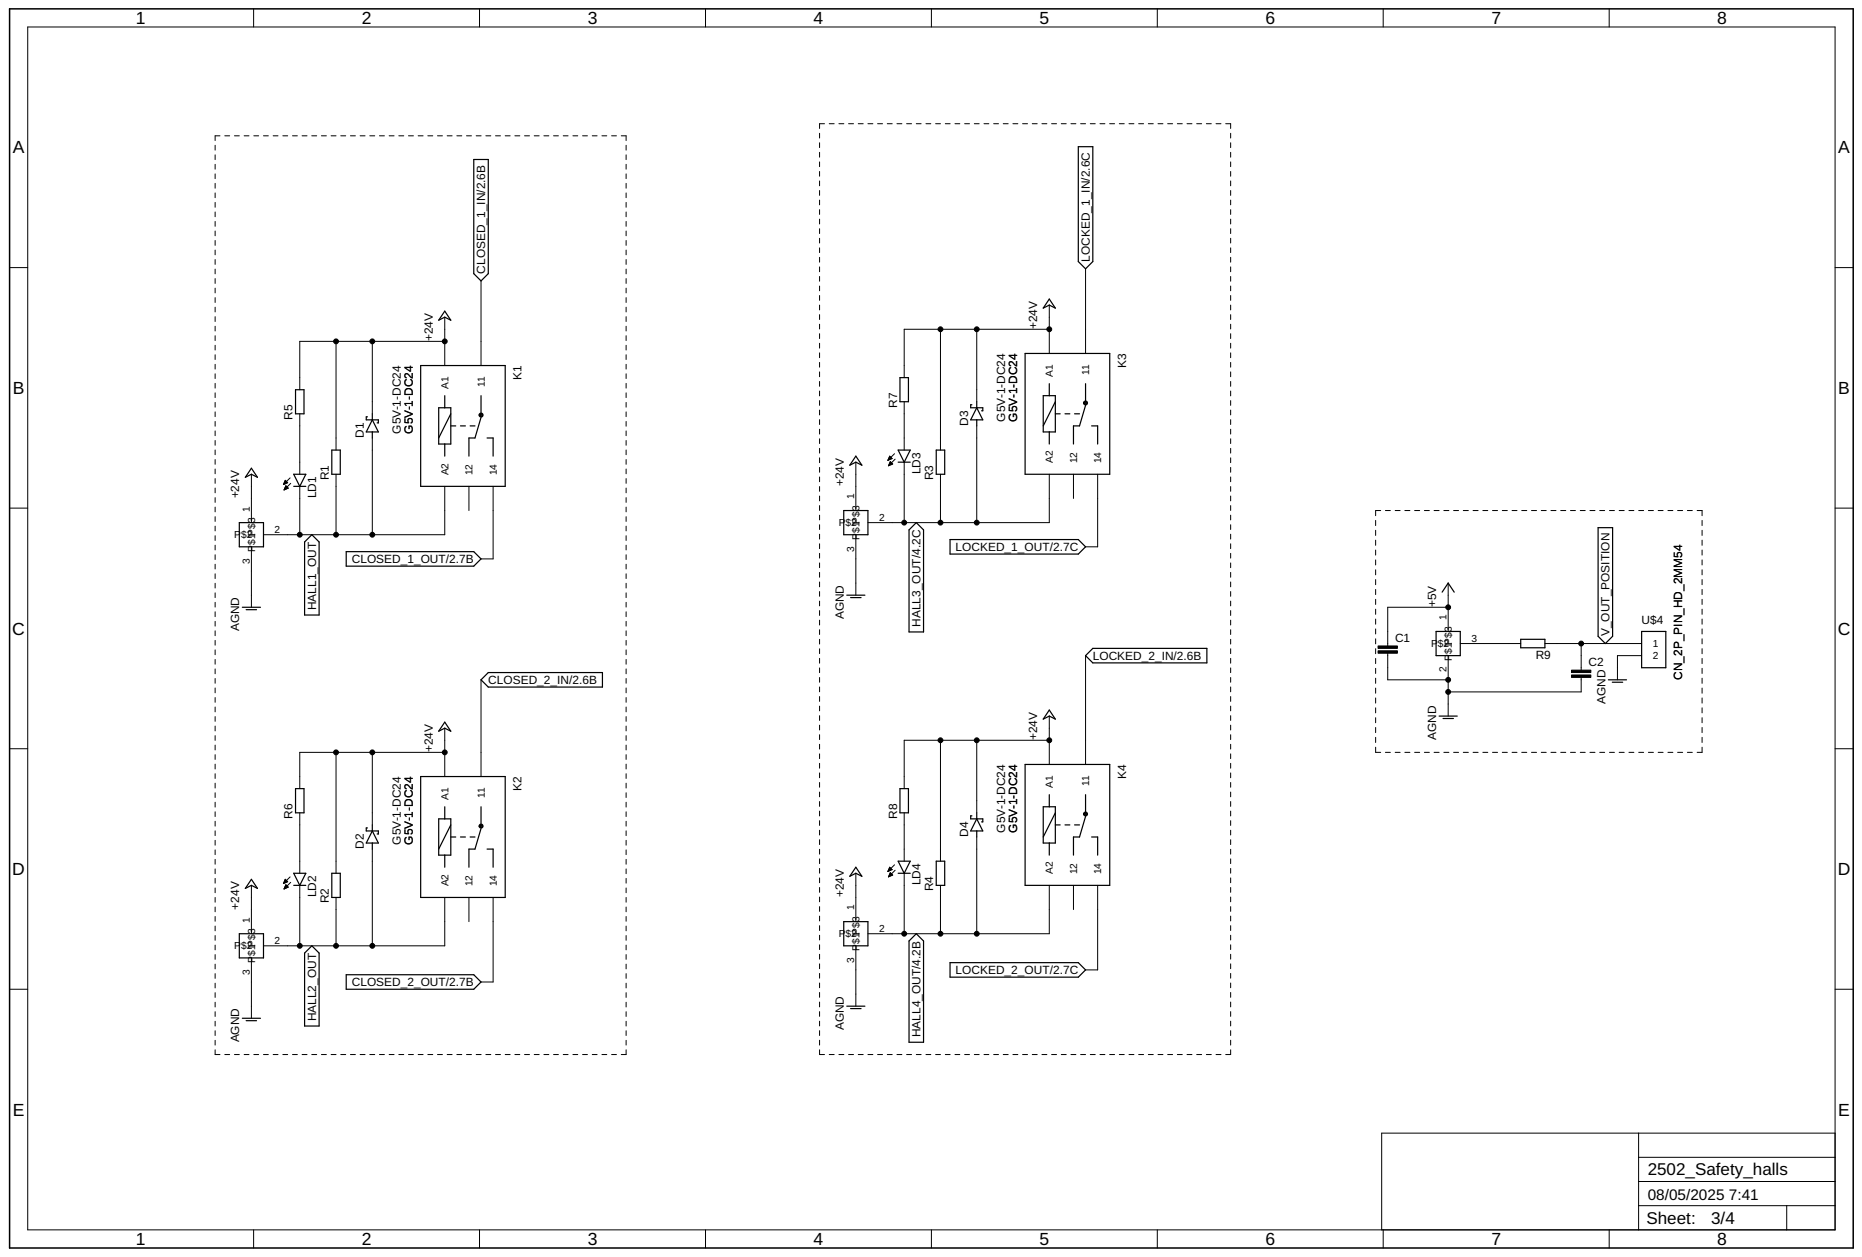
[picture p74: page 3]

G5V-1-DC24 G5V-1-DC24 G5V-1-DC24 G5V-1-DC24 CN_2P_PIN_HD_2MM54 G5V-1-DC24 G5V-1-DC24 G5V-1-DC24 G5V-1-DC24 CN_2P_PIN_HD_2MM54 +24V AGND G5V-1-DC24 +24V +24V AGND G5V-1-DC24 +24V +24V AGND G5V-1-DC24 +24V +24V AGND G5V-1-DC24 +24V AGND +5V AGND 1214 A111 A2 K1 D1 1214 A111 A2 K2 D2 1214 A111 A2 K3 D3 1214 A111 A2 K4 D4 P$1 1 P$2 P2 $3 3 P$1 1 P$2 P2 $3 3 P$1 1 P$2 P2 $3 3 P$1 1 P$2 P2 $3 3 R1 R2 R3 R4 R5 LD1 R6 LD2 R7 LD3 R8 LD4 P$1 1 P$2 P3 $3 2 C1 R9 C2 12 U$4 HALL1_OUT HALL2_OUT HALL3_OUT/4.2C HALL4_OUT/4.2B CLOSED_1_IN/2.6B LOCKED_1_IN/2.6C LOCKED_2_IN/2.6B CLOSED_2_IN/2.6B CLOSED_1_OUT/2.7B LOCKED_1_OUT/2.7C CLOSED_2_OUT/2.7B LOCKED_2_OUT/2.7C V_OUT_POSITION Sheet: ABCDE 1 2 3 4 5 6 7 8 ABCDE 1 2 3 4 5 6 7 8 2502_Safety_halls 08/05/2025 7:41 3/4

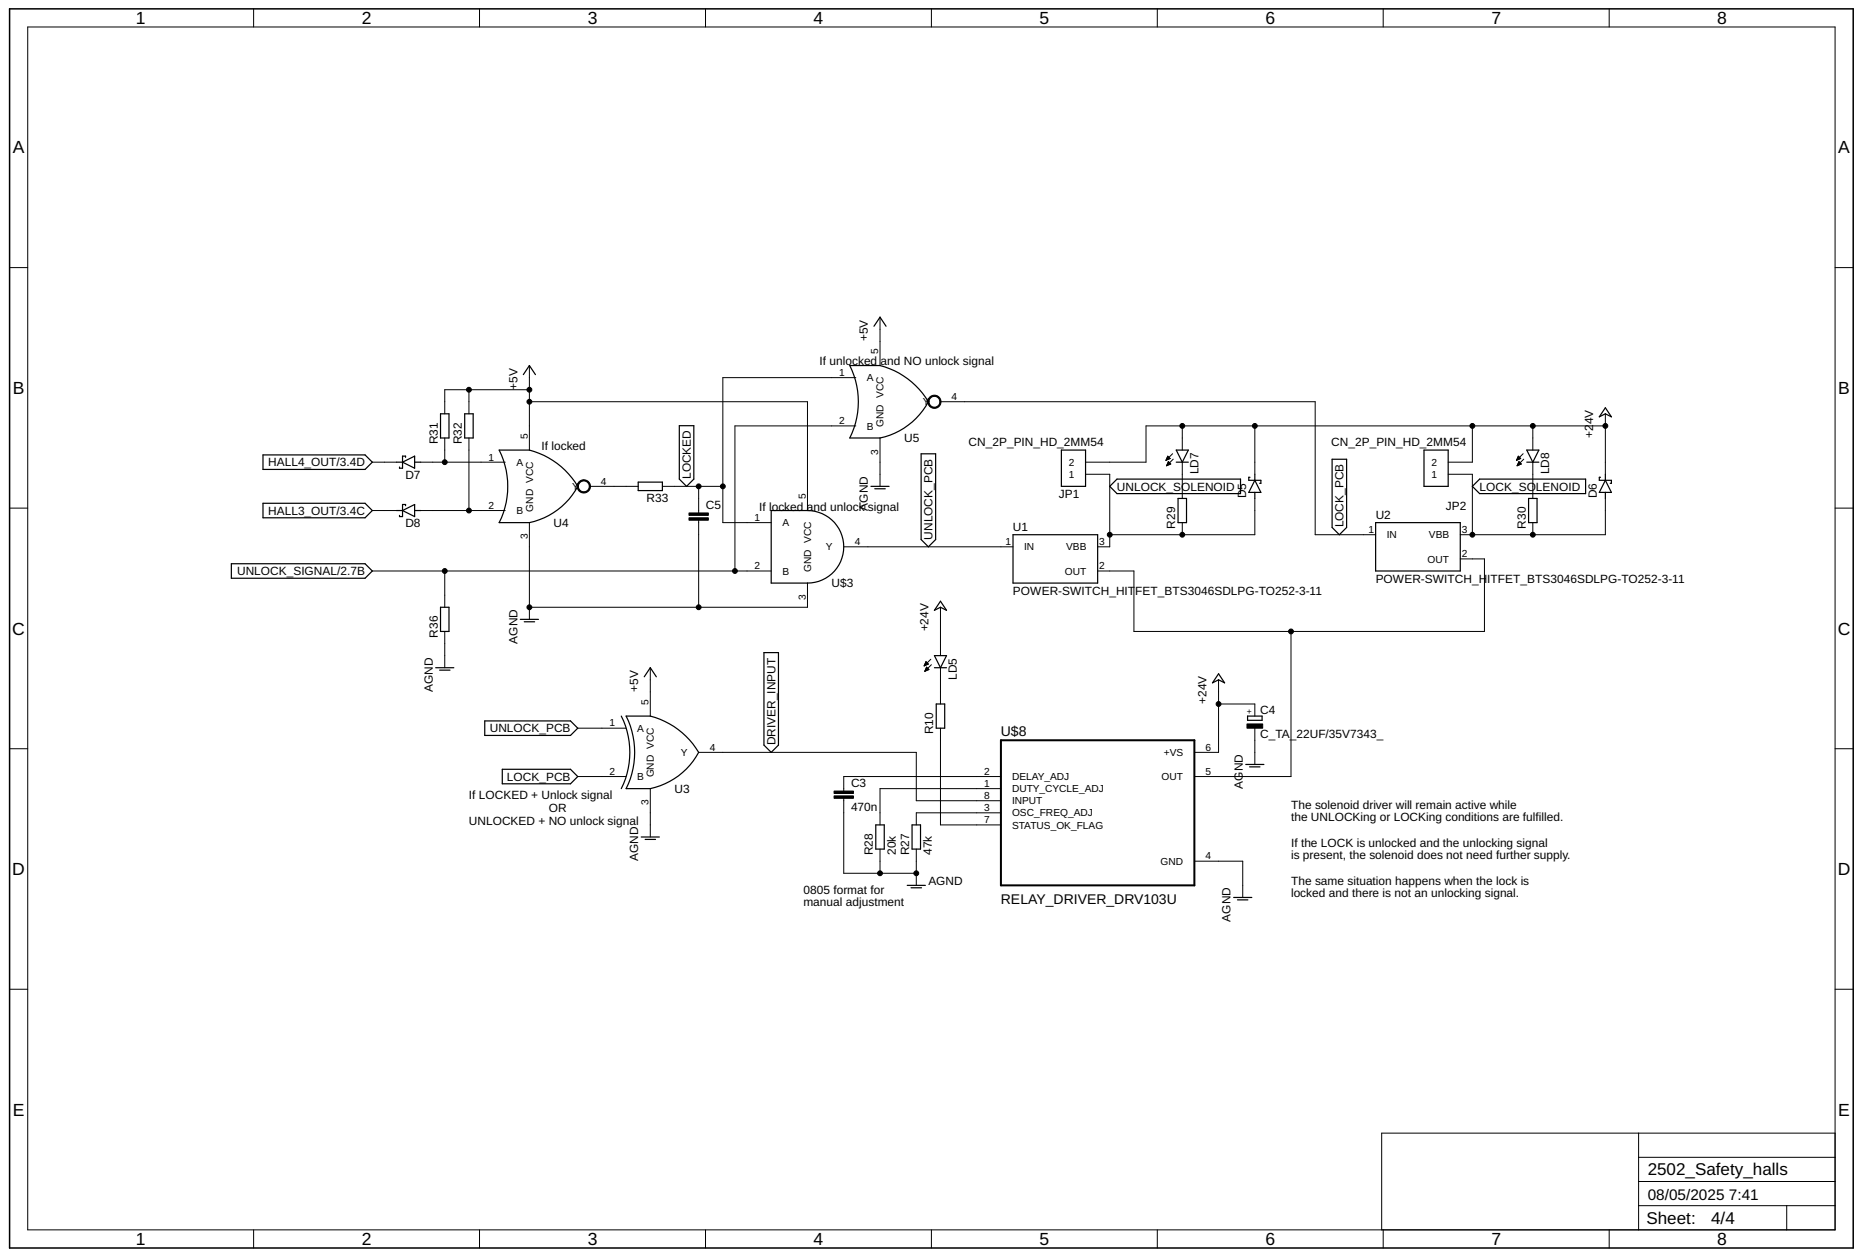
[picture p75: page 4]

If LOCKED + Unlock signal

The solenoid driver will remain active while
the UNLOCKing or LOCKing conditions are fulfilled.

UNLOCKED + NO unlock signal

If the LOCK is unlocked and the unlocking signal
is present, the solenoid does not need further supply. The same situation happens when the lock is

0805 format for manual adjustment

locked and there is not an unlocking signal.
