JavierGranadoCIRCE/Alimak_RFID/RFID_ALIMAK_VGT6/RFID_ALIMAK_VGT6.ioc

Mcu.UserName=STM32F407VGTx
PA0-WKUP.Signal=GPXTI0
PA1.GPIO_Label=RFID_CLK
PA1.Signal=GPXTI1
PA8.Signal=USART1_CK
PA9.Signal=USART1_TX
PD5.Signal=USART2_TX
PD6.Signal=USART2_RX
PD8.Signal=USART3_TX
PD9.Signal=USART3_RX
